nhatbang140901/Project_2/README.md

# Project_2
APPLICATION OF AUTOMATION IN PRODUCT WEIGHT CLASSIFICATION PROCESS
