nhatbang140901/Project_2/(list of files, drawings)

Other design files:
do_an_2/proteus/do_an_2.pdsprj
